ummadi-ajay/open-ear-earbuds/stl/earbud_shell_slim_left.stl

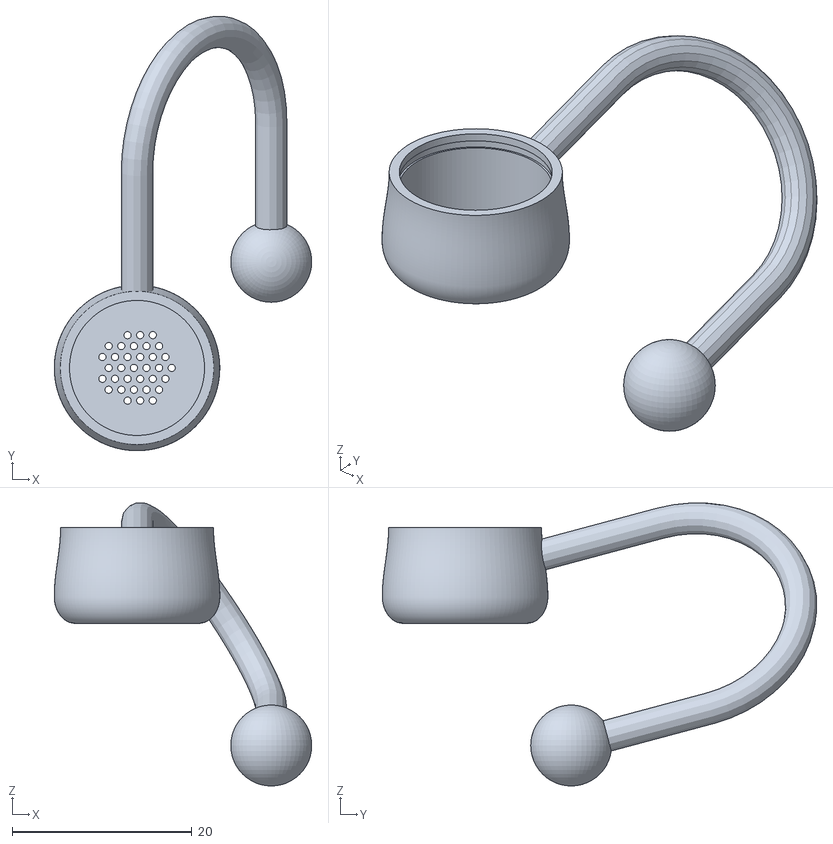
[picture p5: CAD file, 2026-11-06]
stl/earbud_shell_slim_left.stl
28.6 x 48.3 x 31.4
