ummadi-ajay/open-ear-earbuds/stl/earbud_shell_egg_left.stl

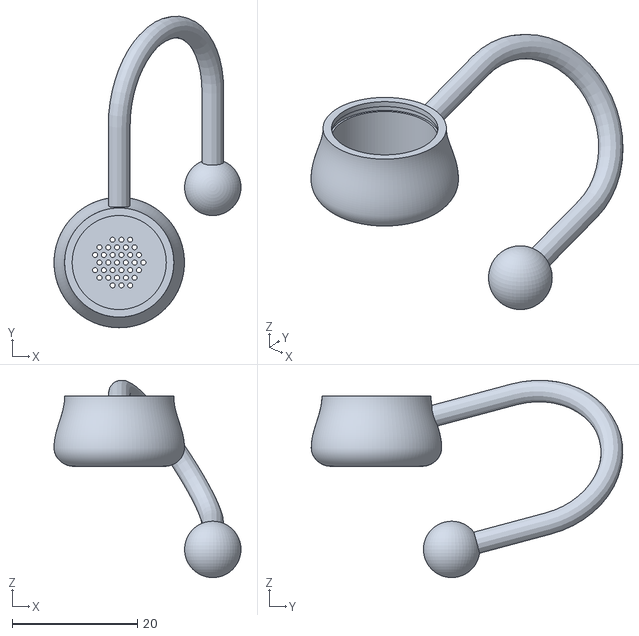
[picture p6: CAD file, 2026-11-06]
stl/earbud_shell_egg_left.stl
29.8 x 49.7 x 31.4
