ummadi-ajay/open-ear-earbuds/stl/earbud_reel_drum.stl

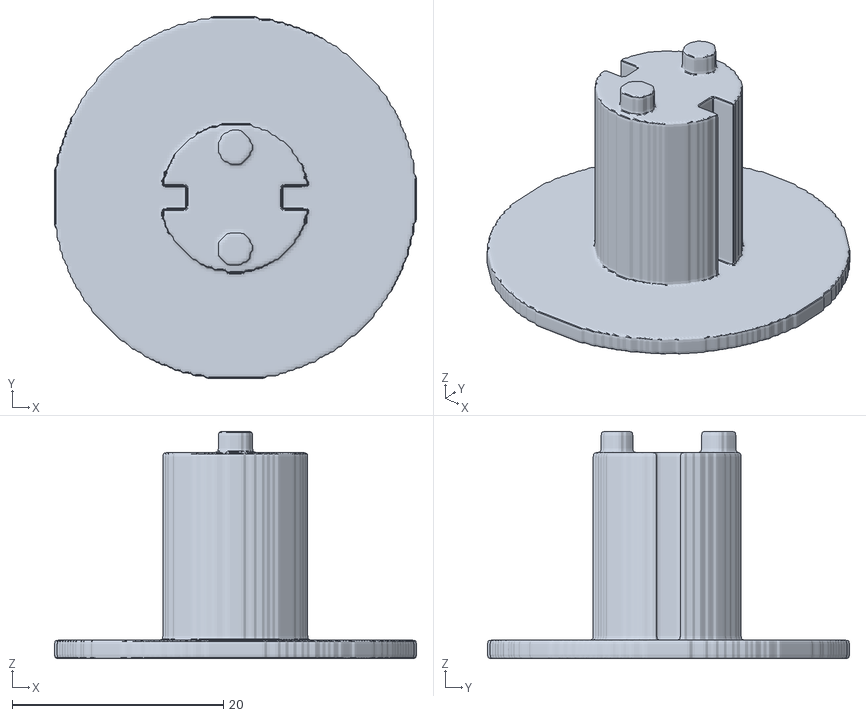
[picture p7: CAD file, 2026-11-06]
stl/earbud_reel_drum.stl
34.2 x 34.2 x 21.5
