ummadi-ajay/open-ear-earbuds/stl/earbud_cap_compact.stl

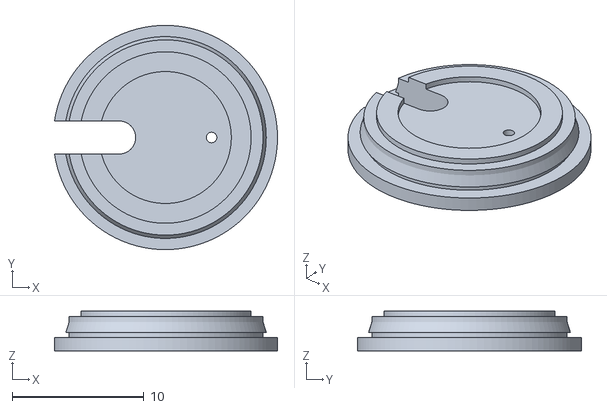
[picture p8: CAD file, 2026-11-06]
stl/earbud_cap_compact.stl
16.9 x 17.0 x 3.00
