ummadi-ajay/open-ear-earbuds/stl/earbud_cap_egg_right.stl

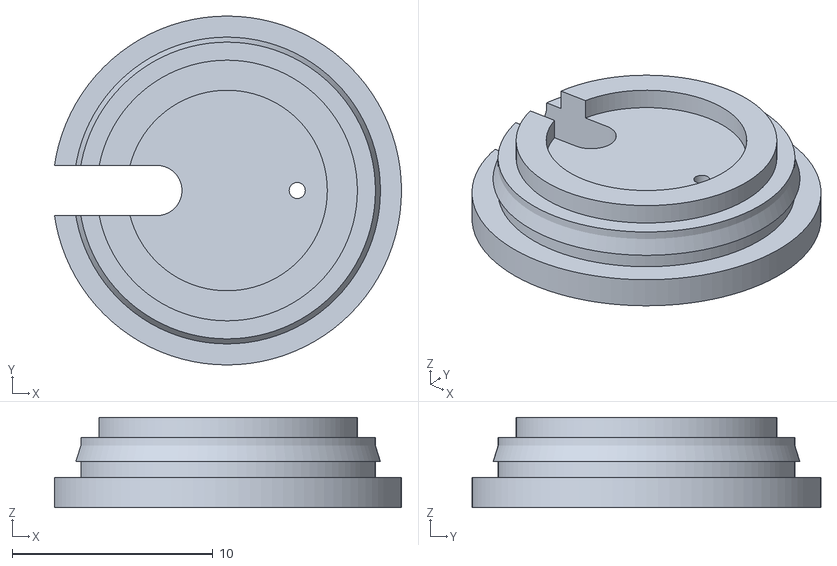
[picture p9: CAD file, 2026-11-06]
stl/earbud_cap_egg_right.stl
17.3 x 17.4 x 4.50
