ummadi-ajay/open-ear-earbuds/stl/earbud_cap_slim_left.stl

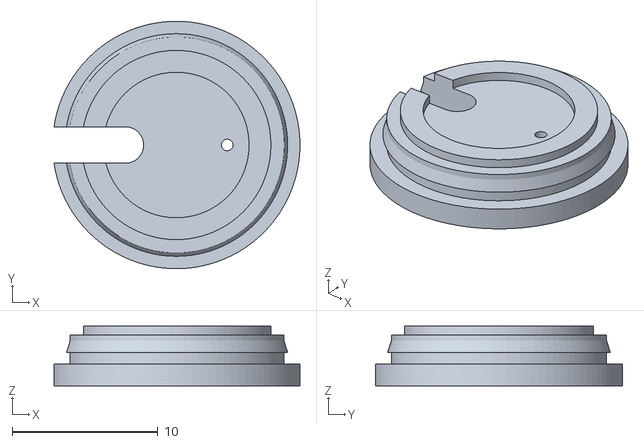
[picture p10: CAD file, 2026-11-06]
stl/earbud_cap_slim_left.stl
16.9 x 17.0 x 4.10
