ummadi-ajay/open-ear-earbuds/stl/earbud_shell_compact_right.stl

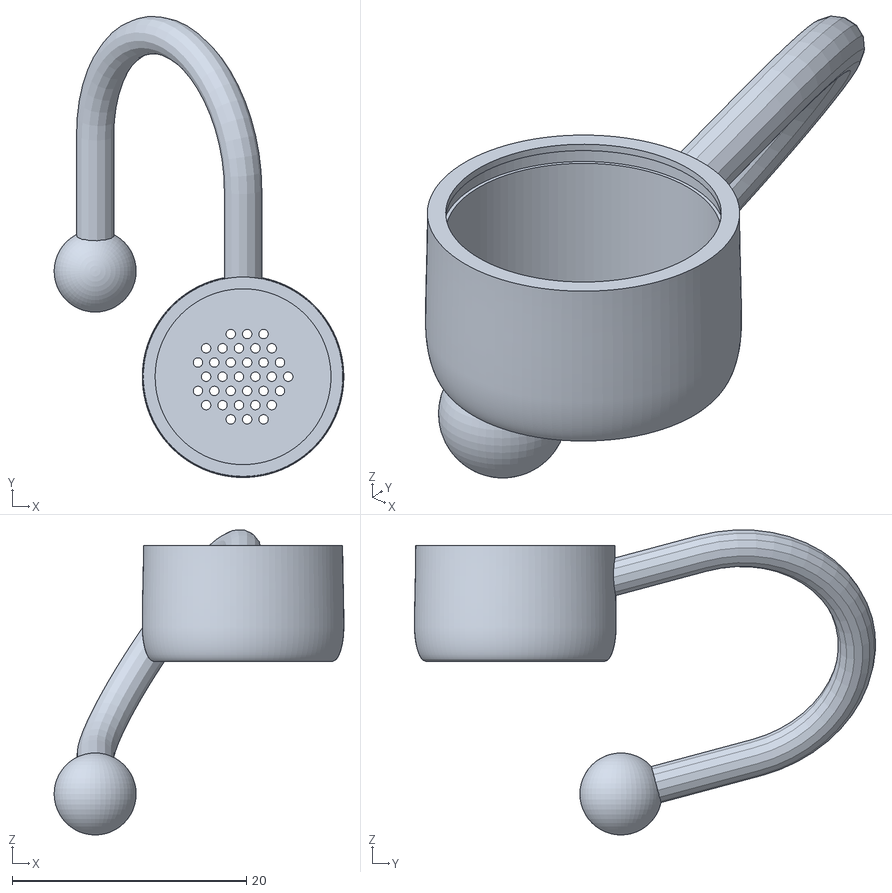
[picture p11: CAD file, 2026-11-06]
stl/earbud_shell_compact_right.stl
24.7 x 39.3 x 26.0
