ummadi-ajay/open-ear-earbuds/stl/earbud_shell_flat11_right.stl

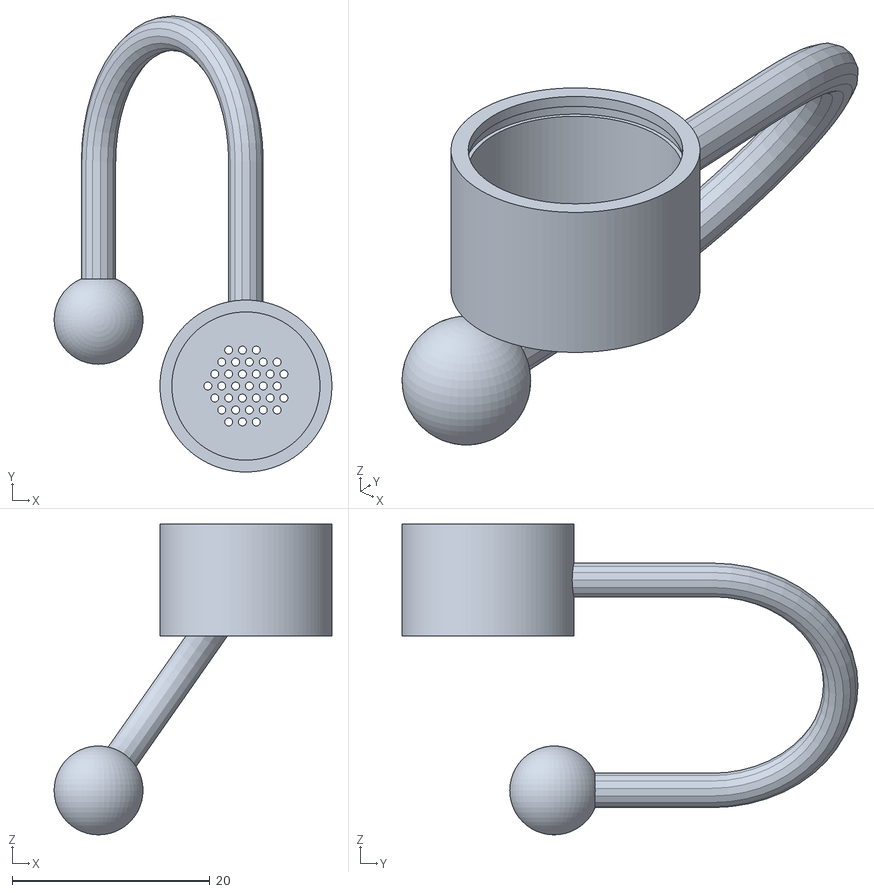
[picture p12: CAD file, 2026-11-06]
stl/earbud_shell_flat11_right.stl
28.1 x 46.1 x 31.4
