ummadi-ajay/open-ear-earbuds/stl/earbud_case_base.stl

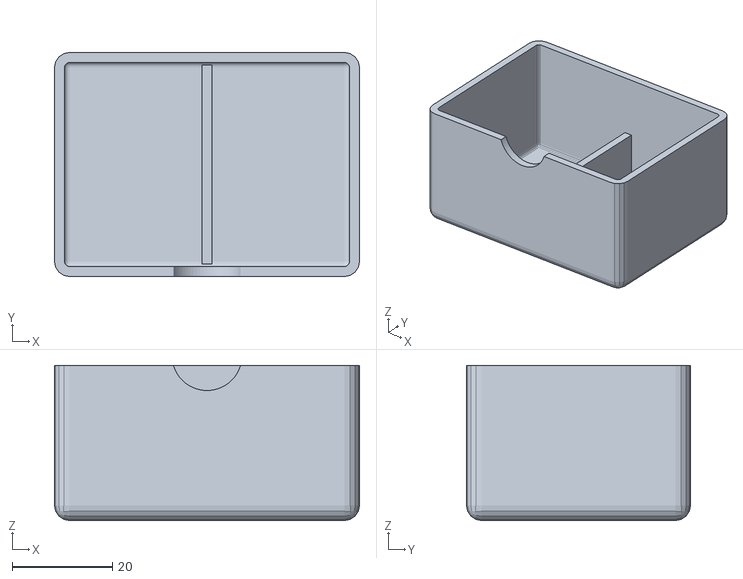
[picture p13: CAD file, 2026-11-06]
stl/earbud_case_base.stl
61.0 x 44.8 x 31.0
