ummadi-ajay/open-ear-earbuds/stl/earbud_case_shaped_lid.stl

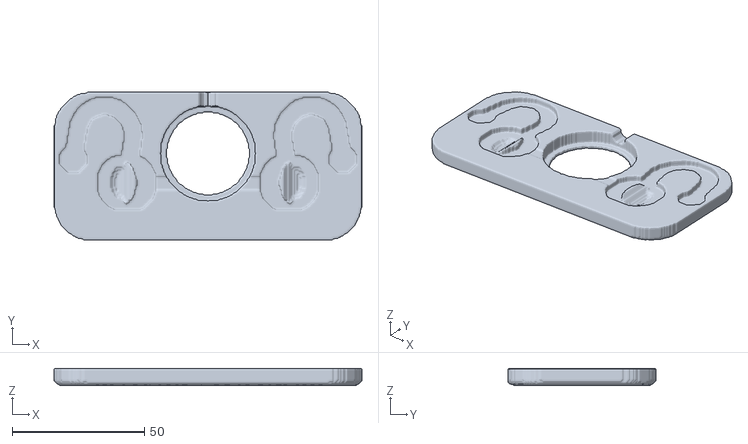
[picture p14: CAD file, 2026-11-06]
stl/earbud_case_shaped_lid.stl
116.5 x 56.0 x 6.50
