ummadi-ajay/open-ear-earbuds/stl/earbud_case_shaped_base.stl

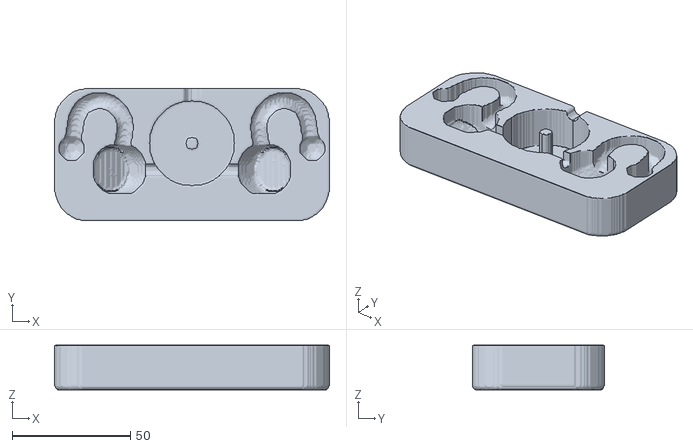
[picture p15: CAD file, 2026-11-06]
stl/earbud_case_shaped_base.stl
116.5 x 56.0 x 19.0
