ummadi-ajay/open-ear-earbuds/stl/earbud_case_lid.stl

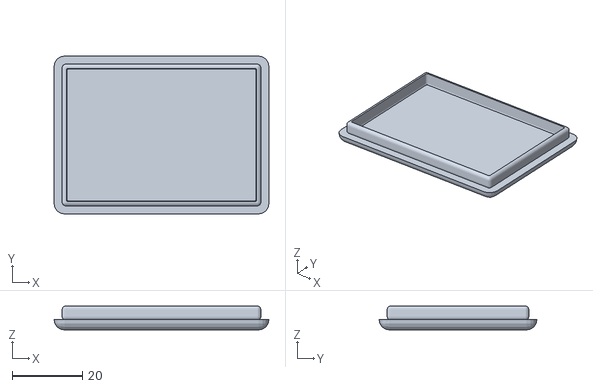
[picture p16: CAD file, 2026-11-06]
stl/earbud_case_lid.stl
61.0 x 44.8 x 6.80
