ummadi-ajay/open-ear-earbuds/stl/earbud_reel_knob.stl

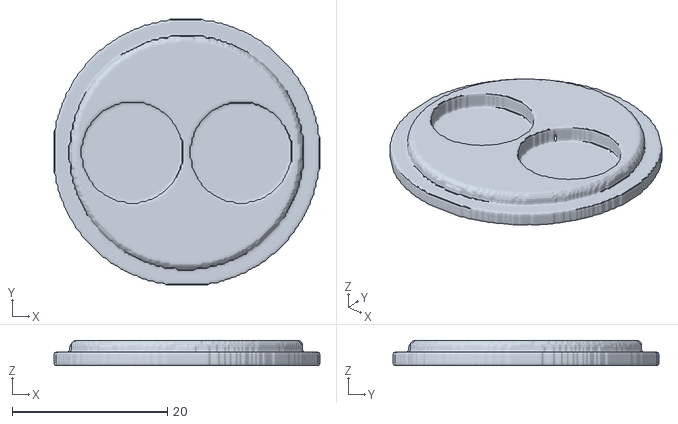
[picture p17: CAD file, 2026-11-06]
stl/earbud_reel_knob.stl
34.2 x 34.2 x 3.25
