ummadi-ajay/open-ear-earbuds/(list of files, cad)

Other CAD files:
stl/earbud_shell_slim_right.stl
stl/earbud_shell_egg_right.stl
stl/earbud_shell_compact_left.stl
stl/earbud_shell_flat11_left.stl
stl/old/earbud_cap_8mm.stl
stl/old/earbud_shell_8mm.stl
